dong-higenis/HG-ESP32-C5-ETH-CANFD485/README.md

# HG-ESP32-C5-ETH-CANFD485

ESP32-C5-DevKitC-1을 꽂아 쓰는 확장 보드다. W5500으로 10/100 이더넷을 만들고, CAN FD 2채널과 RS-485 2채널을 필드 단자로 꺼낸다. 버스 쪽에는 TVS, GDT, PTC, 공통 모드 초크가 들어 있다. MCU는 보드에 없으며, Espressif ESP32-C5-DevKitC-1을 소켓에 장착한다.

실크 표기는 **HiGenis (하이제니스)**, 기판명 `ESP32-C5-ETH-CANFD485`다. 회로도는 [`hardware/esp32_c5_eth_canfd485.pdf`](hardware/esp32_c5_eth_canfd485.pdf) (4장)이다.

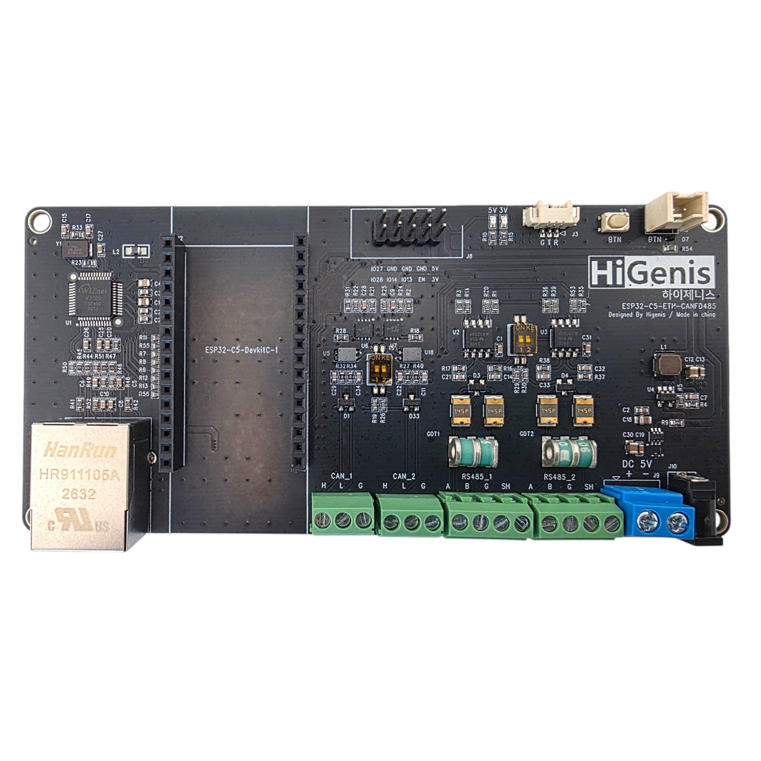
[picture p1: img/정면.jpg]
기판 정면


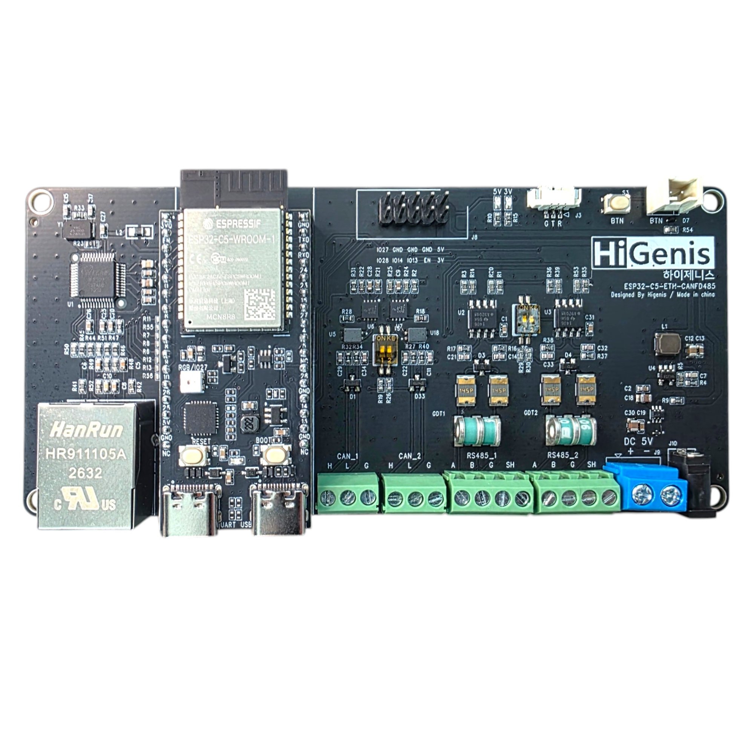
[picture p2: img/정면 + 보드.jpg]
ESP32-C5-DevKitC-1 장착


## 구성

| 구간 | 부품 | 역할 |
| --- | --- | --- |
| MCU | ESP32-C5-DevKitC-1 소켓 | Wi-Fi 6, BLE, 802.15.4 모듈 보드는 데브킷을 그대로 사용 |
| 이더넷 | W5500 + HanRun HR911105A | SPI 이더넷, 마그잭 일체형 RJ45, 링크/액티브 LED |
| CAN FD ×2 | TCAN3413DRBR | 3.3 V CAN FD 트랜시버. 노멀 모드로 고정 |
| RS-485 ×2 | THVD1406DR | 반이중, 자동 방향 제어. DE 핀 없음 |
| 전원 | LM66100, SY8089A1AAC | 5 V 역접속 차단 후 데브킷 5 V 공급, 별도 3.3 V 벅 |

필드 버스는 트랜시버 기준 **비절연**이다. 보호 부품은 서지와 ESD를 막는 용도다.

## 전원

입력은 **DC 5 V만** 사용한다. 5 V는 데브킷 5 V 핀으로 들어가고, 데브킷이 자기 3.3 V를 만든다. 보드의 3.3 V는 W5500, CAN, RS-485, EXT IO용이며 데브킷 3.3 V와 묶여 있지 않다.

입력 커넥터 두 개는 이상적인 다이오드 앞에서 병렬이다. 한 번에 한쪽만 연결한다.

| 커넥터 | 부품 | 극성 |
| --- | --- | --- |
| 나사 단자 J9 | XY118-5.0-2P | 실크 `+` / `−` |
| DC 잭 J10 | 1.3 mm ID / 4.2 mm OD | 센터 `+`, 슬리브 `−` |

경로:

1. D6 `DF2B7AFS`가 5 V 입력을 클램프한다.
2. U8 `LM66100` 이상적인 다이오드가 역극성 입력과 5 V 레일의 역류를 막는다. `/CE`는 100 kΩ으로 GND에 묶여 항상 켜져 있다.
3. 그 출력이 데브킷 5 V와 벅 입력이다.
4. U4 `SY8089A1AAC`(SOT-23-5, 2 A급)가 3.3 V를 만든다. 인덕터 1 µH / 2 A, 귀환 100 kΩ / 22 kΩ, EN은 5 V에 고정이다.

ESP32-C5-DevKitC-1 사용자 가이드에서 USB, 5 V 핀, 3V3 핀 전원은 서로 배타적이다. 이 보드는 데브킷 5 V 핀으로 전원을 넣는다. 캐리어에 5 V를 넣은 상태에서 데브킷 USB를 전원으로 쓰지 않는다.

## 커넥터

아래쪽 단자 실크 순서는 왼쪽부터다.

| 단자 | 실크 | 신호 |
| --- | --- | --- |
| CAN_1, CAN_2 | `H` `L` `G` | CANH, CANL, 신호 GND |
| RS485_1, RS485_2 | `A` `B` `G` `SH` | A, B, 신호 GND, 실드(CHGND) |
| DC 5V | `+` `−` | J9. 오른쪽 잭이 J10 |

`SH`는 회로도 넷 `CHGND`다. A/B의 기준은 보드 GND다.

| 헤더 | 용도 | 핀 |
| --- | --- | --- |
| J8 EXT IO | 2×5, 2.54 mm | 1 `+5V`, 2 `+3.3V`, 3 GND, 4 EN, 5 GND, 6 IO13, 7 GND, 8 IO14, 9 IO27, 10 IO28 |
| J3 | 3핀, 실크 `G` `T` `R` | 데브킷 UART0. TX = GPIO11, RX = GPIO12 |
| J5 | 2핀, 보드 버튼과 병렬 | 외부 버튼. 누르면 GND |
| S3 | 택트 스위치 | GPIO26, 누르면 GND |

GPIO27은 데브킷 온보드 RGB LED와 같은 핀이다. EXT IO에서 쓰면 RGB도 같이 움직인다.

## GPIO

디지털 신호에는 MCU 쪽에 22 Ω이 직렬로 있다. 넷 이름은 회로도에 적힌 GPIO 번호다. 소켓 핀 번호와 데브킷 공식 핀이 전원 핀에서 다르므로, 펌웨어 핀은 [소켓 핀 번호](#소켓-핀-번호)를 보고 실물 1번 핀을 확인한 뒤 정한다.

| 기능 | 회로도 넷 | 비고 |
| --- | --- | --- |
| CAN_1 TX | GPIO23 | TCAN3413 TXD |
| CAN_1 RX | GPIO24 | TCAN3413 RXD |
| CAN_2 TX | GPIO0 | 스트래핑 핀. 트랜시버 TXD 내부 풀업으로 리셋 시 High |
| CAN_2 RX | GPIO1 | |
| RS485_1 TX (D) | GPIO2 | UART TX. 자동 방향 |
| RS485_1 RX (R) | GPIO3 | UART RX |
| RS485_2 TX (D) | GPIO5 | LP UART TX 기본 핀 |
| RS485_2 RX (R) | GPIO4 | LP UART RX 기본 핀 |
| W5500 SCLK | GPIO6 | SPI |
| W5500 MOSI | GPIO7 | 스트래핑 핀 |
| W5500 MISO | GPIO8 | |
| W5500 INT | GPIO9 | Active low, 10 kΩ 풀업 |
| W5500 CS | GPIO10 | Active low |
| W5500 RST | GPIO25 | Active low, 4.7 kΩ 풀업. 스트래핑 핀 |
| 버튼 | GPIO26 | Active low. 외부 풀업 없음. 스트래핑 핀 |
| UART0 TX / RX | GPIO11 / GPIO12 | J3 테스트 헤더 |
| 예비 | GPIO13, GPIO14, GPIO27, GPIO28 | J8. GPIO27·GPIO28은 스트래핑 핀 |
| 데브킷 EN | EN | J8 4번. 데브킷 RST와 같은 신호 |

GPIO15는 소켓에만 있고 EXT IO로는 나오지 않는다. CAN STB, RS-485 `/RE`, `/SHDN`은 GPIO로 제어하지 않는다.

ESP32-C5의 TWAI 두 채널을 CAN_1, CAN_2에 붙이면 된다. 핀은 GPIO 매트릭스로 지정한다. RS-485는 UART로 다루면 된다. `/RE`와 `/SHDN`이 3.3 V에 풀업되어 있어 THVD1406은 자동 방향 모드다. TX가 Low일 때 드라이버가 켜지고, 유휴는 High다. THVD1406의 최대 속도는 500 kbps다.

W5500 SPI는 모드 0 또는 3이다. PMODE[2:0]은 열려 있고 내부 풀업이라 기본값은 `111`, 10/100 자동 협상이다. 클럭은 25 MHz 수정이다.

## 종단과 버튼

DIP 스위치는 2극이다. ON이면 그 채널에 120 Ω이 붙는다. 버스 양 끝 노드만 켠다.

| 스위치 | 채널 | 저항 |
| --- | --- | --- |
| S1 | CAN_1, CAN_2 | R19, R26, 각 120 Ω |
| S2 | RS485_1, RS485_2 | R29, R30, 각 120 Ω |

RS-485 A/B에는 4.7 kΩ 페일세이프 바이어스가 있다. 버튼(S3, J5)은 D7 `MKESD0402MS05`로 ESD를 받고 GPIO26으로 간다. 펌웨어에서 풀업을 켠다. GPIO26은 스트래핑 핀이므로 리셋 중에는 누르지 않는다.

D2, D10은 5 V와 3.3 V 표시 LED다.

## 필드 보호

CAN 한 채널:

- 트랜시버 `TCAN3413`. VIO(5번 핀)는 3.3 V, STB는 10 kΩ으로 GND라 노멀 모드다. 버스 내성 ±58 V. CAN FD는 5 Mbps까지 규격 동작이고, 단순한 네트워크에서는 8 Mbps까지 가능하다.
- 공통 모드 초크 `DLW32SH101XF2L` (100 Ω @ 100 MHz)과 0 Ω 링크
- TVS `ESDCAN24-2BLY`
- CANH, CANL 각각 22 pF to GND
- 스위치 종단 120 Ω

2026-10-08 수정에서 CAN 트랜시버 5번 핀을 GND에서 3.3 V로 바꿨다. TCAN3413의 5번 핀은 SHDN이 아니라 VIO라, 3.3 V에 연결해야 TXD/RXD/STB 로직이 동작한다.

RS-485 한 채널:

- 트랜시버 `THVD1406`, 3.3 V, IEC ESD
- A/B 각각 PTC `MF-MSMF014` (홀드 140 mA)
- TVS `SM712-02HTG` (RS-485용, −7 V / +12 V 비대칭)
- 3극 GDT `2036-09-SM-RPLF` (90 V) → CHGND
- A/B 각각 100 pF to GND
- 페일세이프 4.7 kΩ, 스위치 종단 120 Ω

이더넷:

- RJ45 `HR911105A` 마그잭. 2 kV, 1000 pF와 75 Ω Bob Smith 종단
- 차동 라인 49.9 Ω, 아날로그 3.3 V는 페라이트 비드 L2 (120 Ω @ 100 MHz)로 분리
- EXRES1 = 12.4 kΩ, TOCAP = 4.7 µF
- 잭의 녹색/황색 LED는 W5500 `ACTLED`, `LINKLED`

고정 구멍은 3.2 mm, 4곳이다.

## 소켓 핀 번호

회로도 J12·J13은 ESP32-C5-DevKitC-1의 J1·J3에 대응한다. GPIO 이름 순서는 대체로 공식 핀과 같지만, **전원 핀과 J3 1번이 공식 핀 배치와 다르다.**

장착 사진에서 데브킷은 USB가 단자 쪽, 안테나가 그 반대다. 그 방향에서 데브킷 왼쪽 헤더의 안테나 쪽 실크는 `3V3`이고, 오른쪽 헤더의 안테나 쪽 실크는 `GND`다. 공식 J1 1번 = 3V3, J3 1번 = GND와 같다.

회로도는 J12 1번을 `+5V`, 14번을 GND로 그린다. 풋프린트 1번이 데브킷 J1 1번과 같으면 5 V가 데브킷 3V3 핀으로 들어가고, 데브킷 5 V 핀(J1 14번)은 GND에 붙는다. **전원을 넣기 전에 캐리어 소켓 1번과 데브킷 1번이 어디에 맞물리는지 확인한다.**

### J12 — 데브킷 J1 (RJ45 쪽 헤더)

| 핀 | 회로도 | DevKitC-1 J1 |
| --- | --- | --- |
| 1 | +5V | 3V3 |
| 2 | EN | RST |
| 3 | IO2 | GPIO2 |
| 4 | IO3 | GPIO3 |
| 5 | IO0 | GPIO0 |
| 6 | IO1 | GPIO1 |
| 7 | IO6 | GPIO6 |
| 8 | IO7 | GPIO7 |
| 9 | IO8 | GPIO8 |
| 10 | IO9 | GPIO9 |
| 11 | IO10 | GPIO10 |
| 12 | IO26 | GPIO26 |
| 13 | IO25 | GPIO25 |
| 14 | GND | 5V |
| 15 | GND | GND |
| 16 | GND | NC |

2~13번은 공식 J1과 같다. 1번과 14번만 전원 배치가 다르다.

### J13 — 데브킷 J3 (단자 쪽 헤더)

| 핀 | 회로도 | DevKitC-1 J3 |
| --- | --- | --- |
| 1 | TX | GND |
| 2 | RX | TX, GPIO11 |
| 3 | IO24 | RX, GPIO12 |
| 4 | IO23 | GPIO24 |
| 5 | IO15 | GPIO23 |
| 6 | IO27 | GPIO15 (보드에 따라 NC) |
| 7 | IO4 | GPIO27 |
| 8 | IO5 | GPIO4 |
| 9 | GND | GPIO5 |
| 10 | GND | NC |
| 11 | IO28 | GPIO28 |
| 12 | GND | GND |
| 13 | IO14 | GPIO14 |
| 14 | IO13 | GPIO13 |
| 15 | GND | GND |
| 16 | GND | NC |

회로도 1번이 TX라, 공식 핀 번호 그대로면 UART TX 넷이 데브킷 GND 핀에 닿고 이후 GPIO가 한 칸씩 밀린다. J3 6번은 데브킷 버전에 따라 GPIO15 또는 NC다.

## 회로도 수정

| 날짜 | 내용 |
| --- | --- |
| 2026-10-08 | CAN 트랜시버 5번 핀 GND → 3.3 V. 수동 소자 Value에 패키지 정보 추가 |

장 구성: 수정 내역, MCU & POWER, PERIPHERAL, ETHERNET.
