dong-higenis/HG-ESP32-C5-ETH-CANFD485/img/사선.jpg

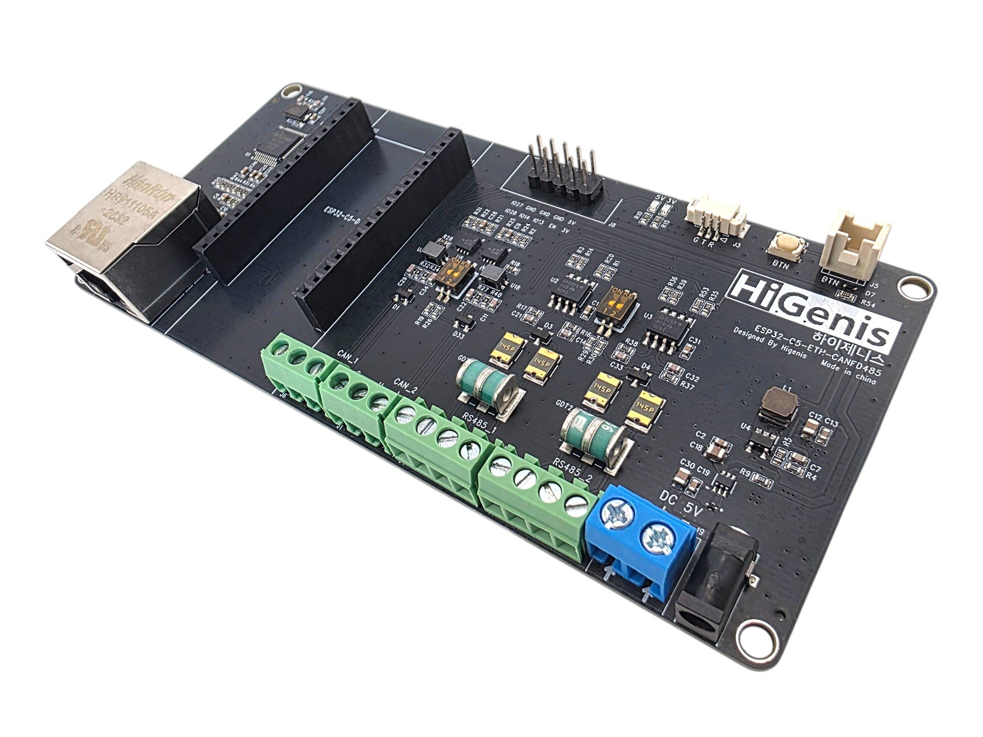
img/사선.jpg
