dong-higenis/HG-ESP32-C5-ETH-CANFD485/hardware/esp32_c5_eth_canfd485.pdf

C

B

A

C

D

6 | 5 | 4 | 3 | 2 | 1

D

B

A

26.10.08 CAN | : 5 | GND -> 3.3V 트랜시버 회로 수정 번핀
수동 소자 | 수정 패키지 정보 추가 Value | :

# 수정 내역

D

6 | 5 | 4 | 3 | 2 | 1

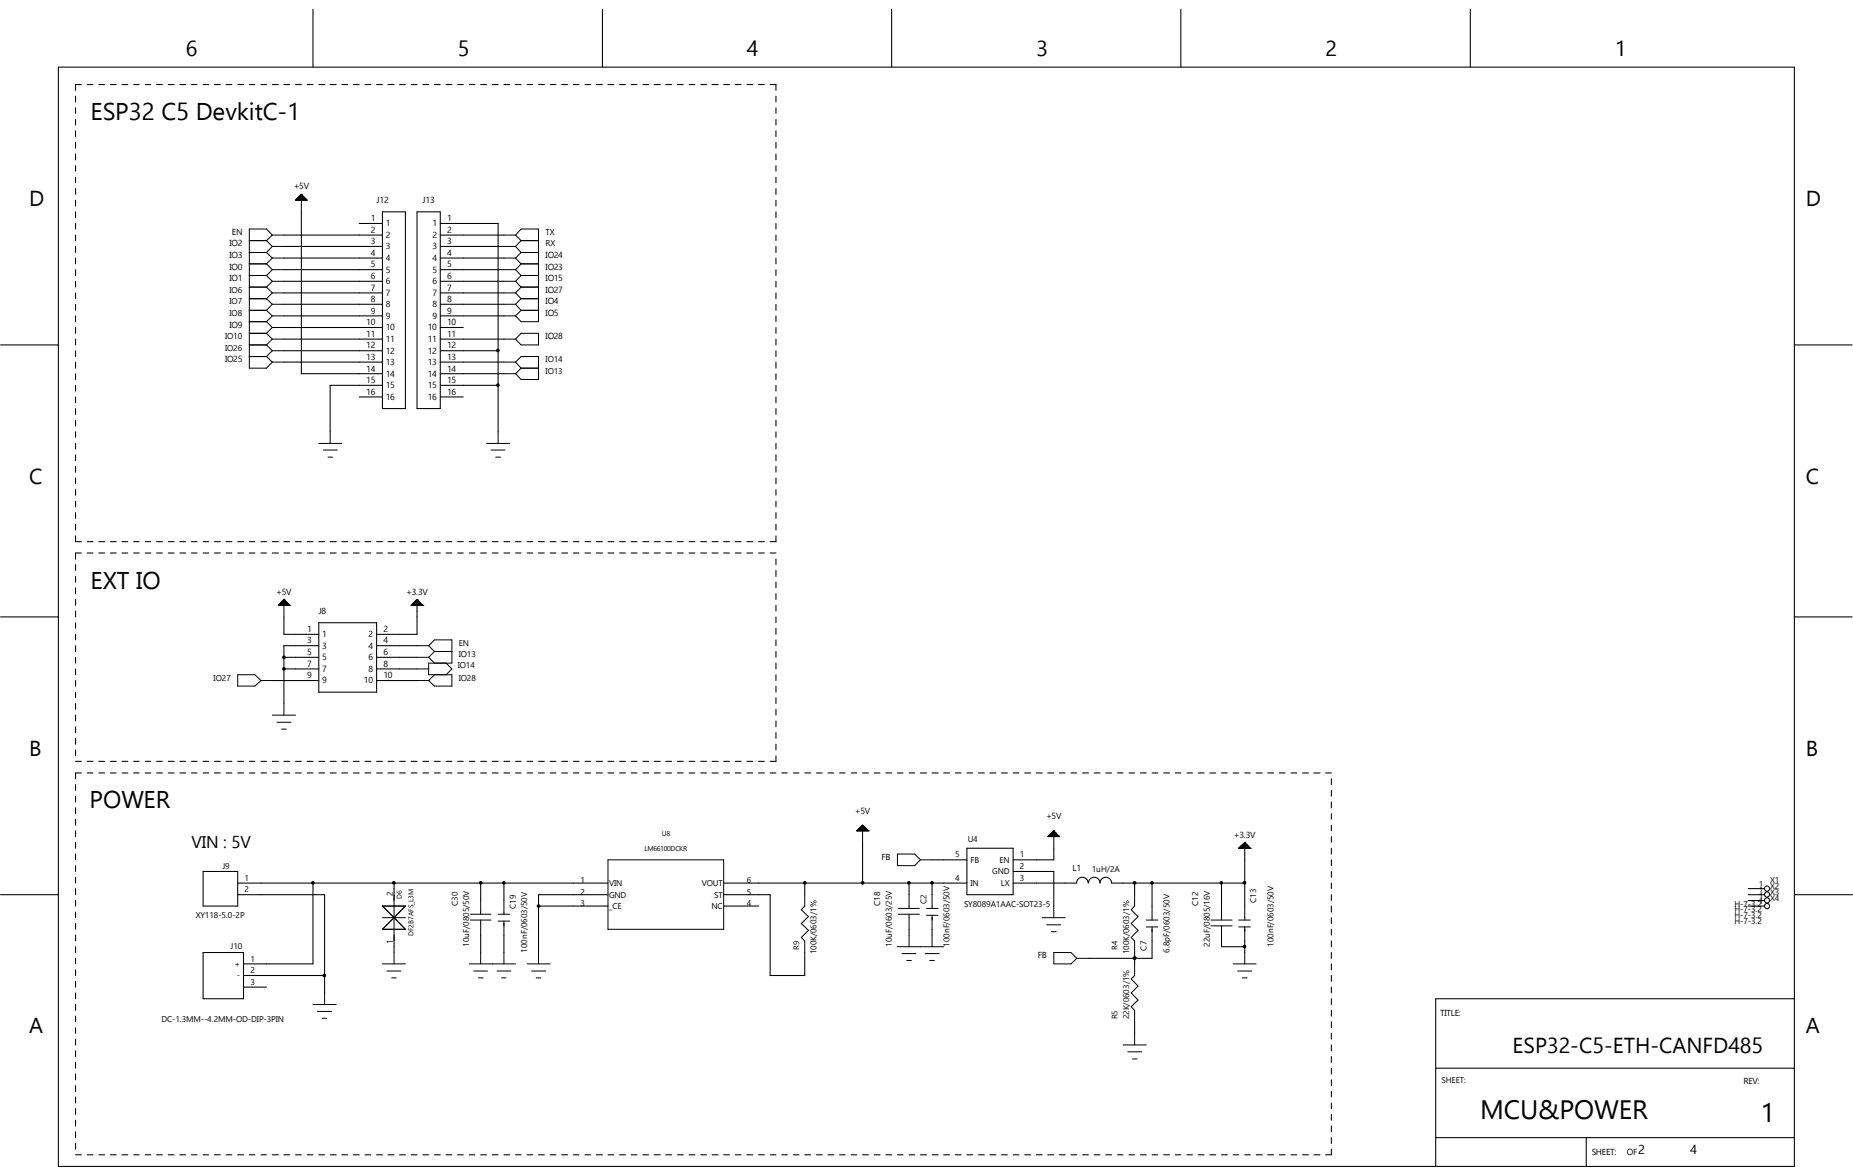
[picture p4: page 2]

RS485

D

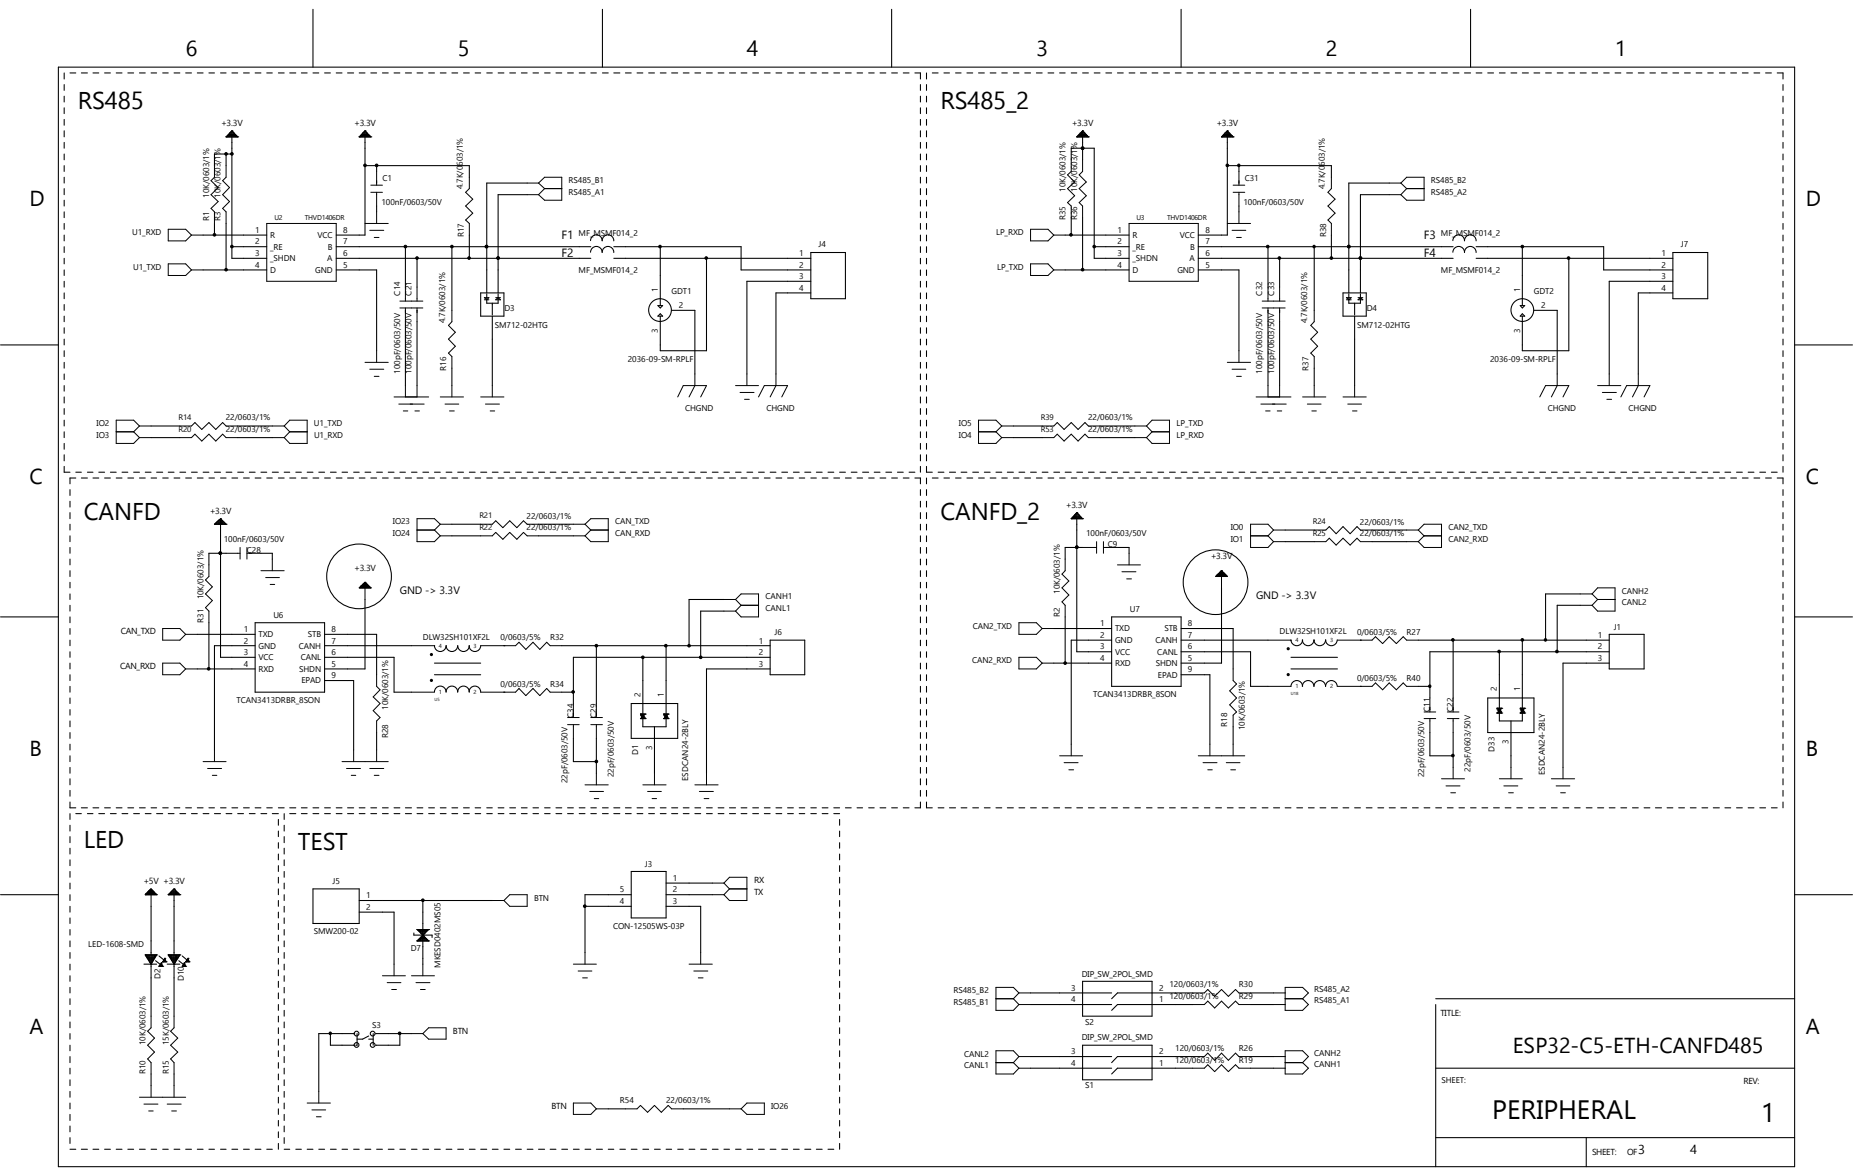
[picture p5: page 3]

2036-09-SM-RPLF C¹⁴ 100pF/0603/50V C²¹ 100pF/0603/50V

2036-09-SM-RPLF C³² 100pF/0603/50V C³³ 100pF/0603/50V

D

6 | 5 | 4 | 3 | 2 | 1

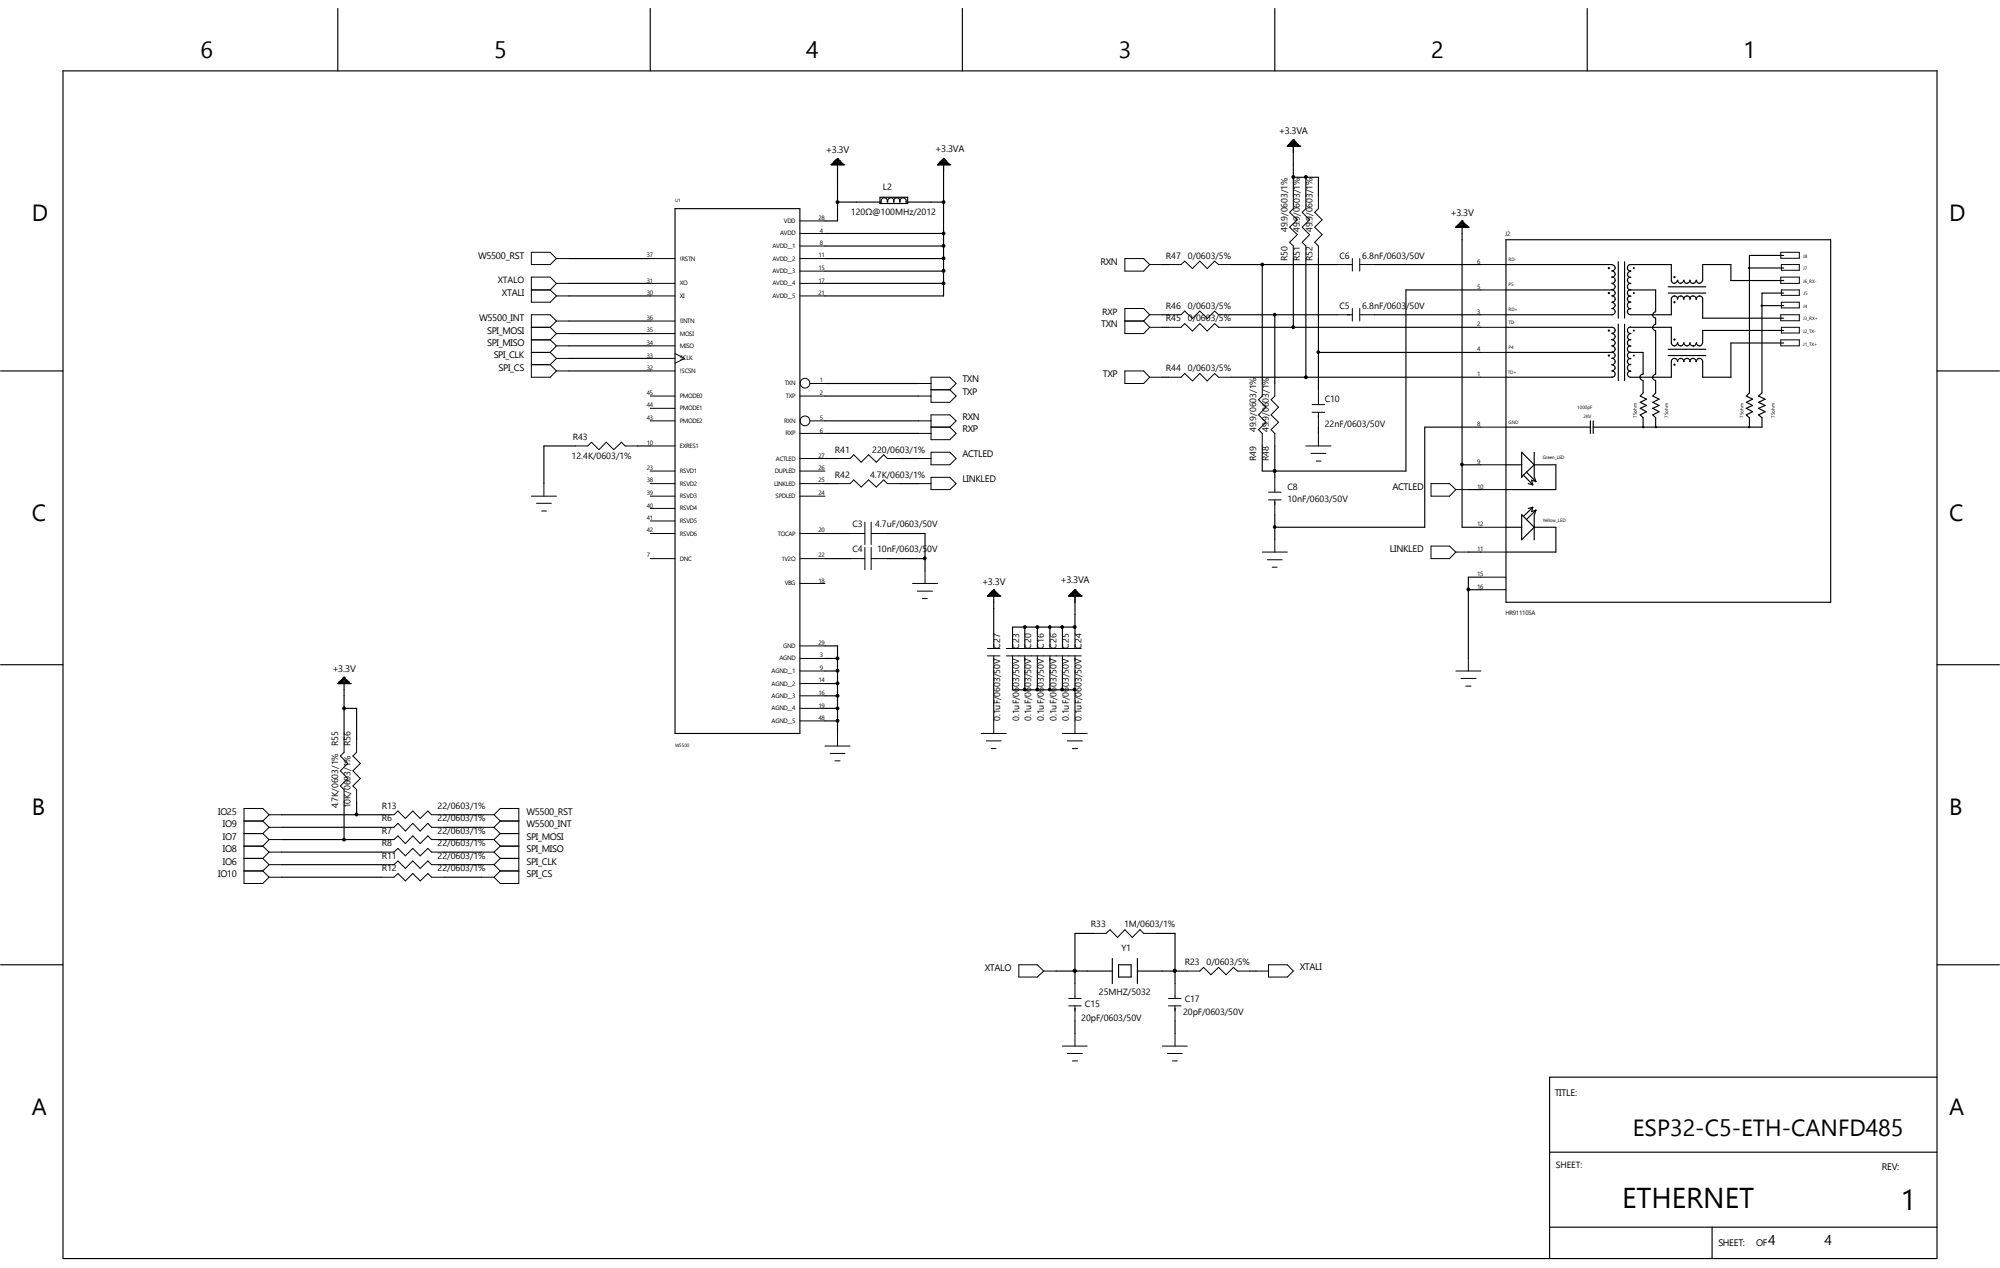
[picture p6: page 4]
