dong-higenis/HG-ESP32-C5-ETH-CANFD485/(commit log)

2026-10-26 firmware commit <Arduino Example>
2026-10-26 회로도 추가
